Patil-Vinay/Robocon-2022/docs/wiring/r1_schematic.png

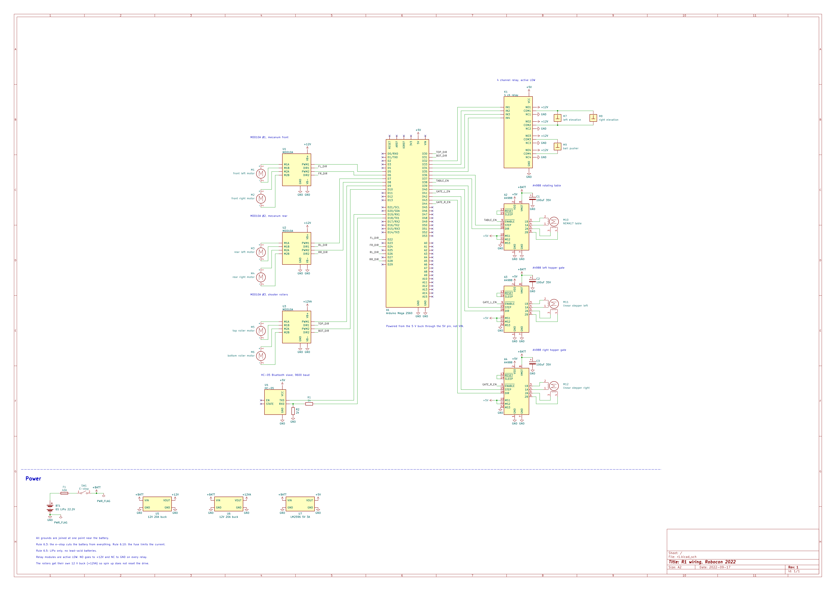
docs/wiring/r1_schematic.png
