Patil-Vinay/Robocon-2022/docs/wiring/r2_schematic.png

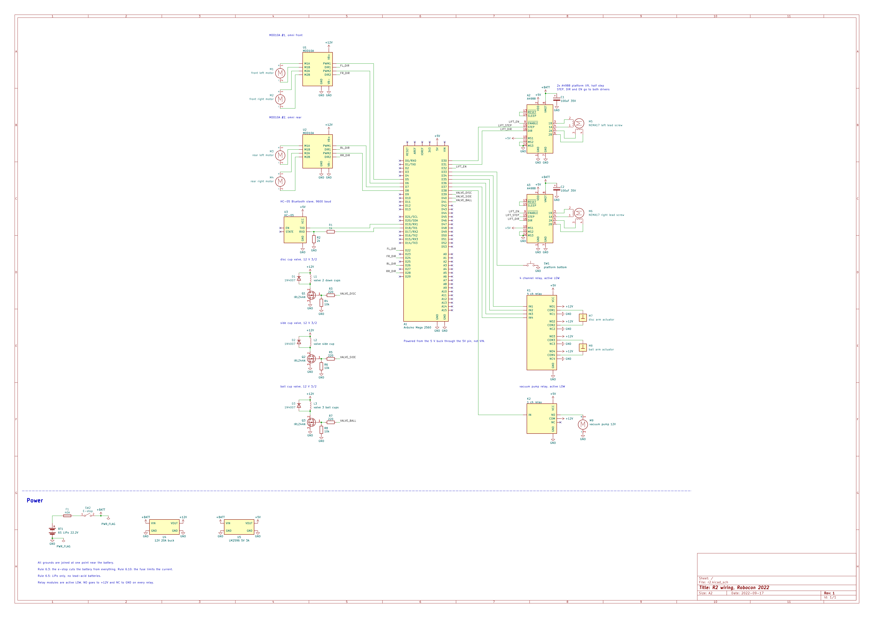
docs/wiring/r2_schematic.png
