Patil-Vinay/Robocon-2022/docs/wiring/remote_schematic.png

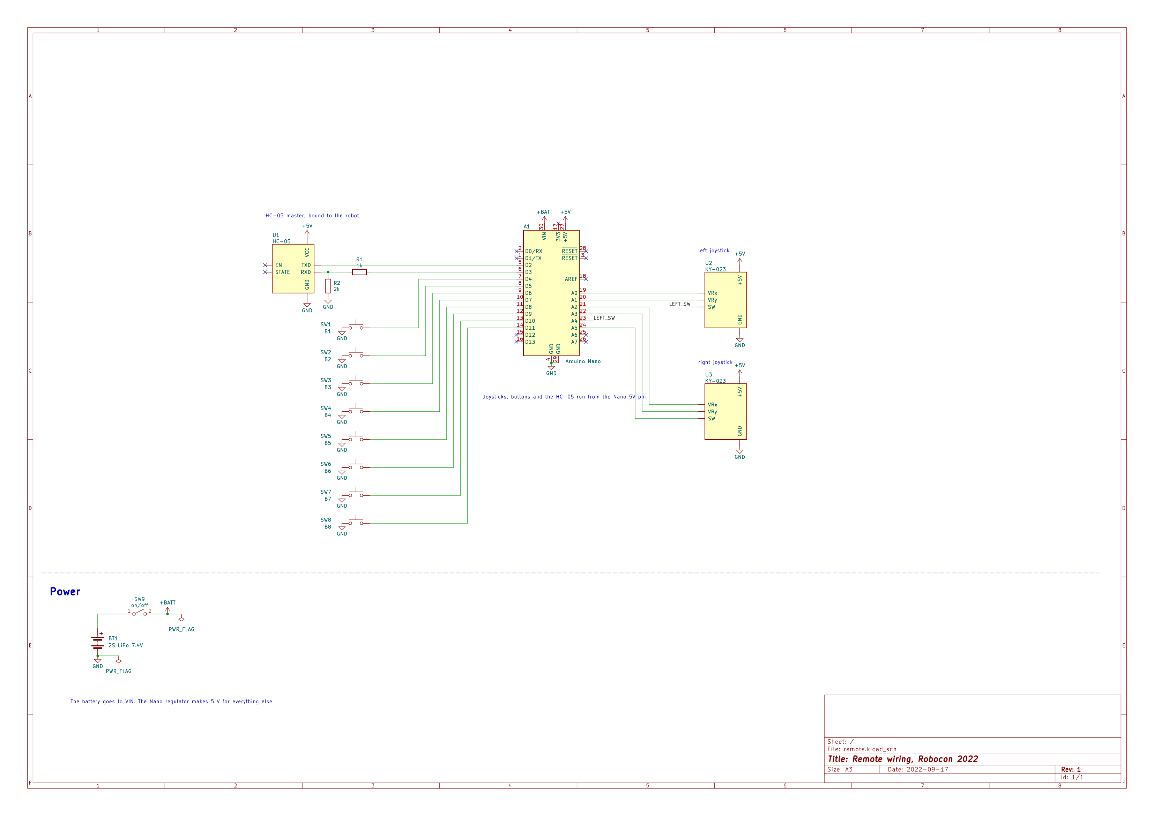
docs/wiring/remote_schematic.png
