Patil-Vinay/Robocon-2022/R1_Robot_Design.png

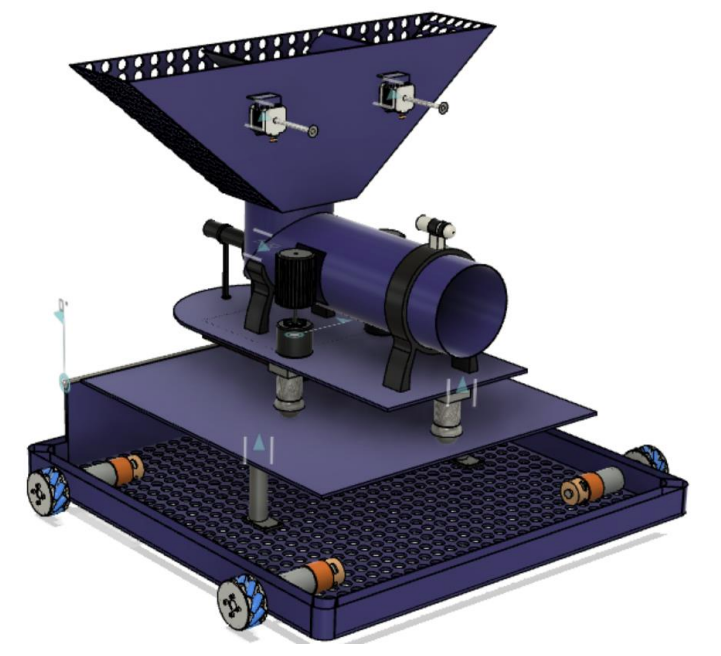
R1_Robot_Design.png
