Patil-Vinay/Robocon-2022/cad/r1/r1_body.step

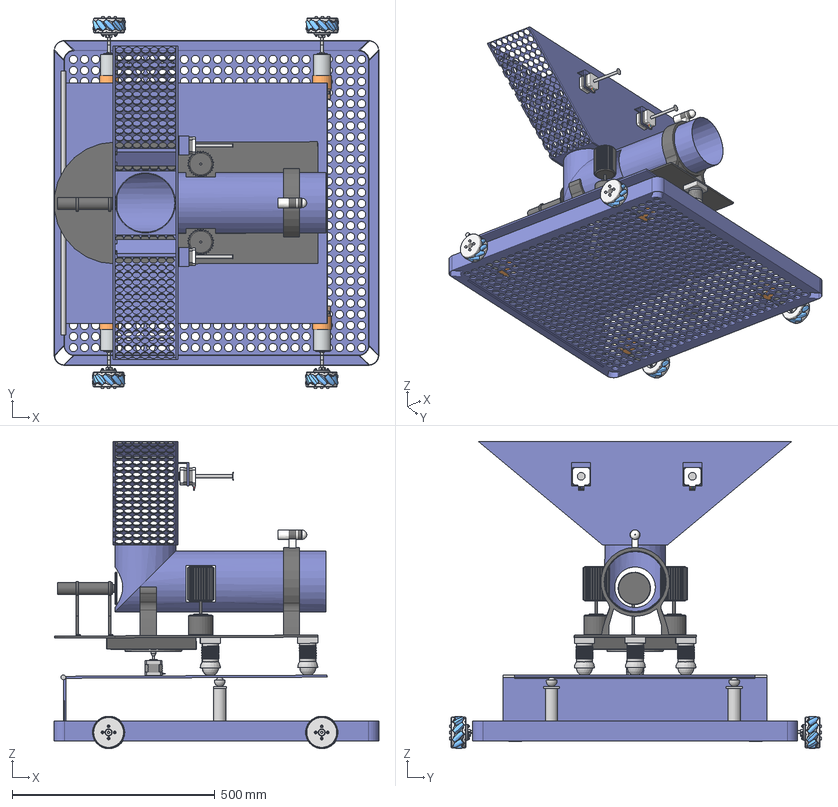
[picture p8: CAD file, 2022-07-25]
cad/r1/r1_body.step
800.0 x 916.4 x 756.4 mm
Caster Wheel x 3
R.Table Gear&Hydraulics
roatating table perforated
hinge
hinge part
M4 Screw 20mm x 2
M4 Screw 20mm (1) x 2
M4 Screw 20mm (2) x 2
M4 Screw 20mm (3) x 2
Cap x 2
Base x 2
Core Laminate x 2
Parts x 2
Parts1
DC Mega torque motor 12 V x 4
Wheel outer side Left x 4
Wheel base plate 1 Left x 4
Roller 3 x 40
Shaft Coupler Nema 17 x 4
hex nut style 1 gradeab_din_Hexagon Nut ISO 4032 - M4 - W - N x 16
Roller Shaft x 40
socket head cap screw_am_B18.3.1M - 4 x 0.7 x 45 Hex SHCS -- 20NHX x 16
