Patil-Vinay/Robocon-2022/cad/r2/parts/omni_wheel.step

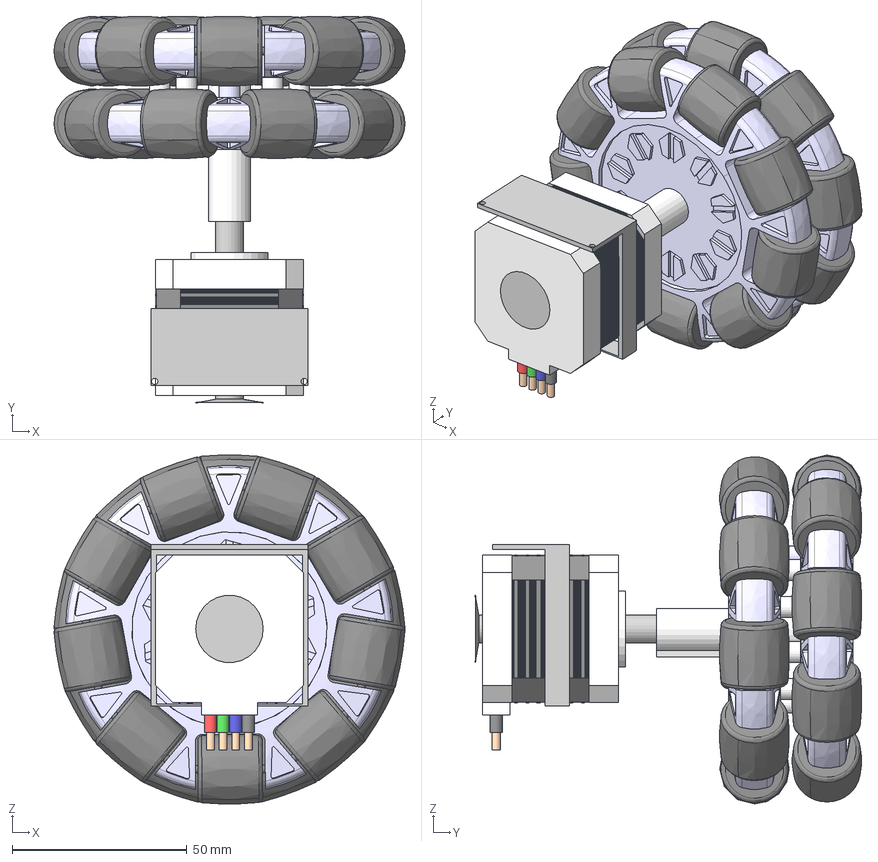
[picture p9: CAD file, 2022-07-25]
cad/r2/parts/omni_wheel.step
100.5 x 110.7 x 99.9 mm
Omnidirectional Wheel
Omnidirectional Wheel1
screw
bolt
