Patil-Vinay/Robocon-2022/cad/r2/r2_body.step

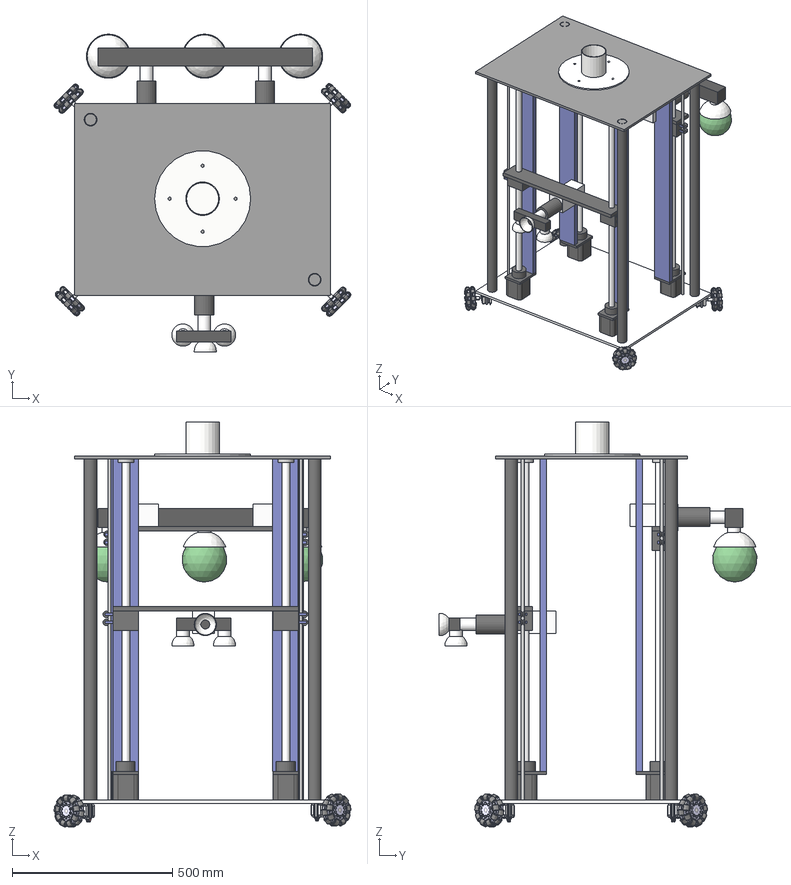
[picture p10: CAD file, 2022-07-25]
cad/r2/r2_body.step
926.9 x 992.5 x 1265.0 mm
lifting support (1) x 2
lifting support x 2
lifting shaft x 4
ball bearings x 4
lifting mechanism screw x 4
lifting mechanism x 4
shaft support x 4
suction cup support (2) x 2
linear actuator body x 3
linear actuator rod (1) x 3
linear actuator rod x 3
suction cup support
suction cup support (1) x 5
suction cups (1) x 3
wheels x 8
wheels (1) x 8
wheel body x 16
Omnidirectional Wheel x 4
Omnidirectional Wheel1 x 4
screw x 4
bolt x 4
suction cup support (3)
suction cups x 3
robot top plate
pLATE
