Patil-Vinay/Robocon-2022/r1 parts_/Rotating Table Mechanism v16.step

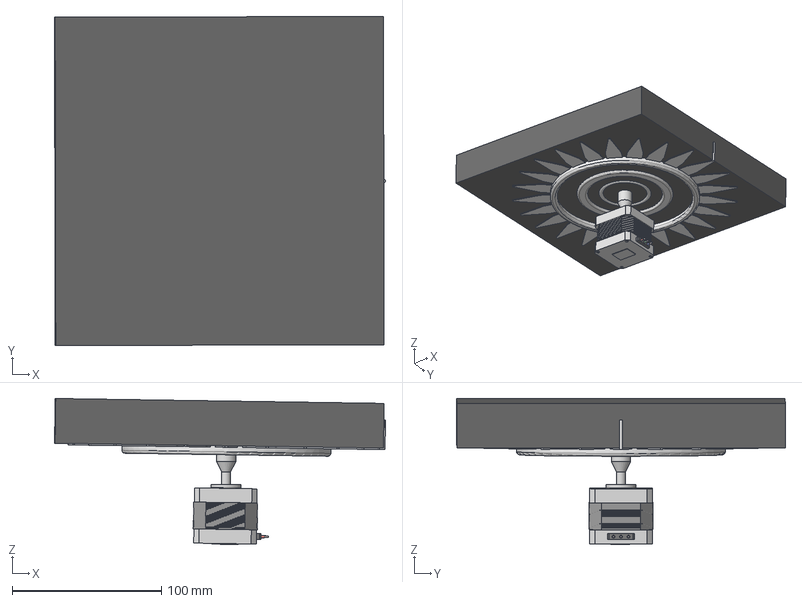
[picture p11: CAD file, 2022-07-17]
r1 parts_/Rotating Table Mechanism v16.step
221.7 x 220.4 x 97.8 mm
R.Table Gear&Hydraulics
