Patil-Vinay/Robocon-2022/r2 parts_/Head plate.step

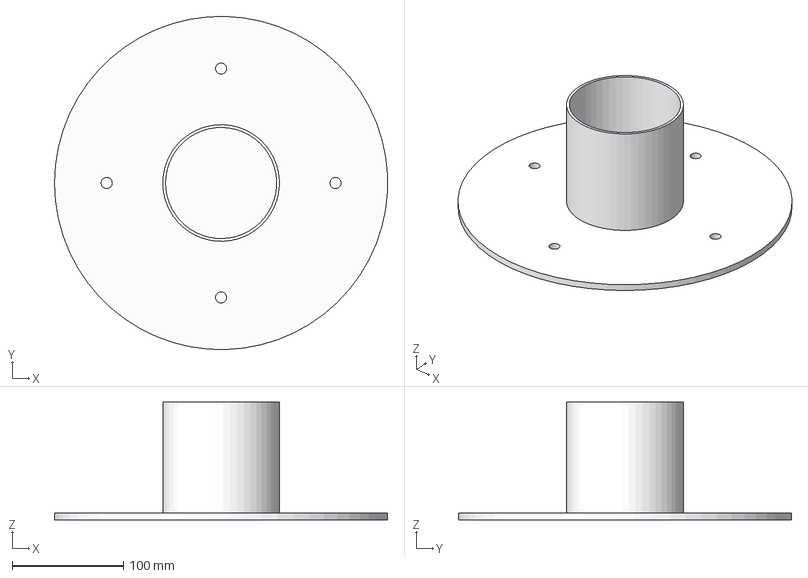
[picture p12: CAD file, 2022-07-17]
r2 parts_/Head plate.step
299.8 x 299.9 x 106.0 mm
