Patil-Vinay/Robocon-2022/cad/r1/parts/seeker_lagori_breaking.step

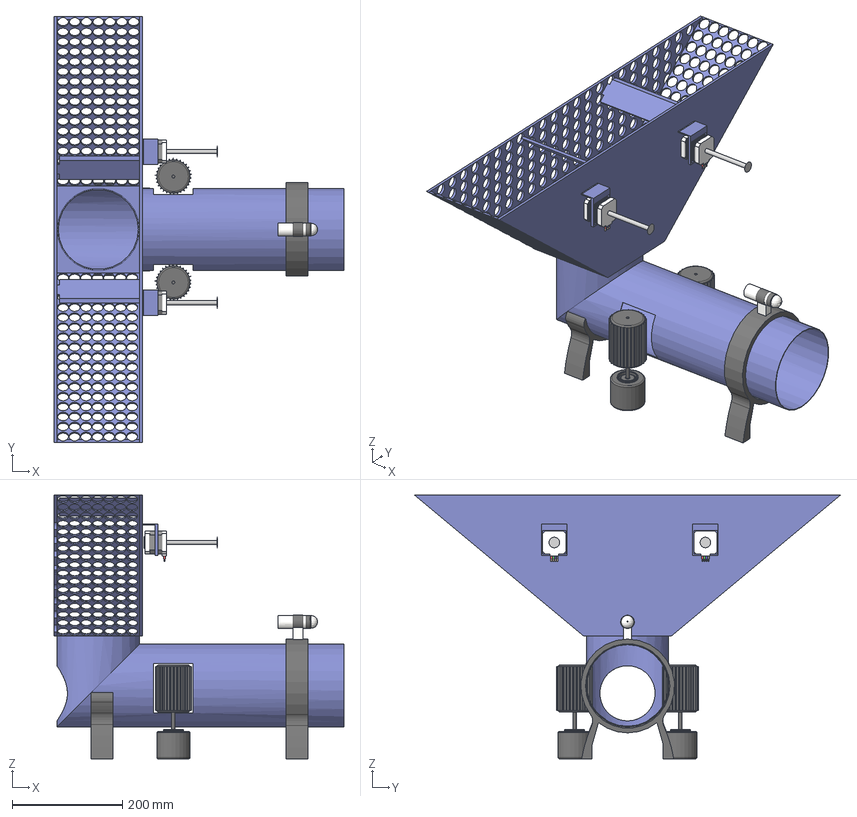
[picture p13: CAD file, 2022-07-25]
cad/r1/parts/seeker_lagori_breaking.step
525.0 x 772.0 x 478.0 mm
Parts x 2
Parts1
