Patil-Vinay/Robocon-2022/cad/r2/parts/hitter_ball_picking.step

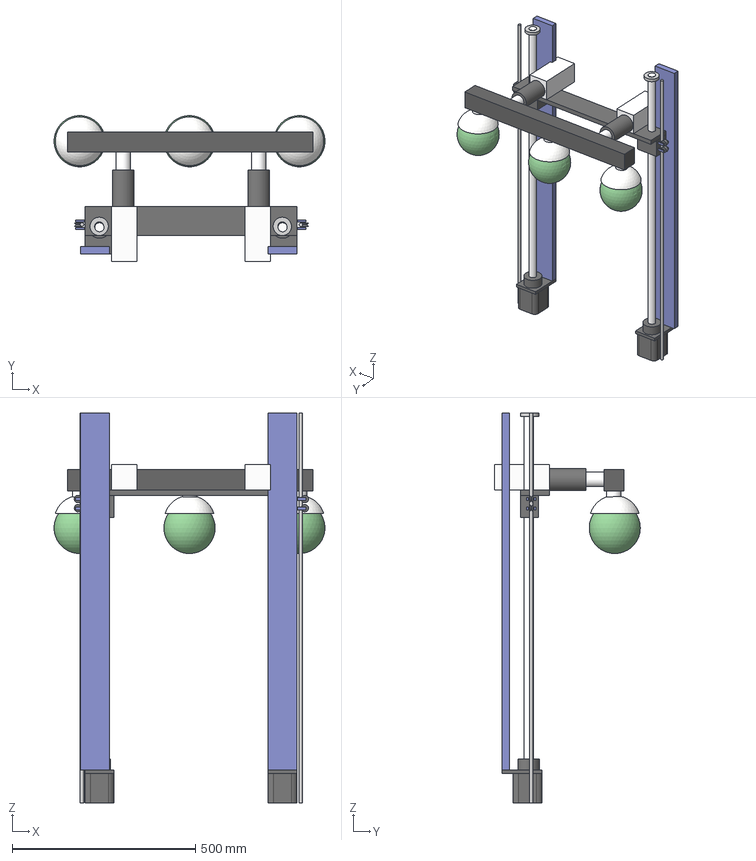
[picture p14: CAD file, 2022-07-17]
cad/r2/parts/hitter_ball_picking.step
739.7 x 397.7 x 1065.0 mm
lifting support (1)
lifting support
lifting shaft x 2
ball bearings x 2
lifting mechanism screw x 2
lifting mechanism x 2
shaft support x 2
suction cup support (2)
linear actuator body x 2
linear actuator rod (1) x 2
linear actuator rod x 2
suction cup support
suction cup support (1) x 3
suction cups (1) x 3
wheels x 4
wheels (1) x 4
wheel body x 8
