Patil-Vinay/Robocon-2022/r1 parts_/roatating table perforated v7.step

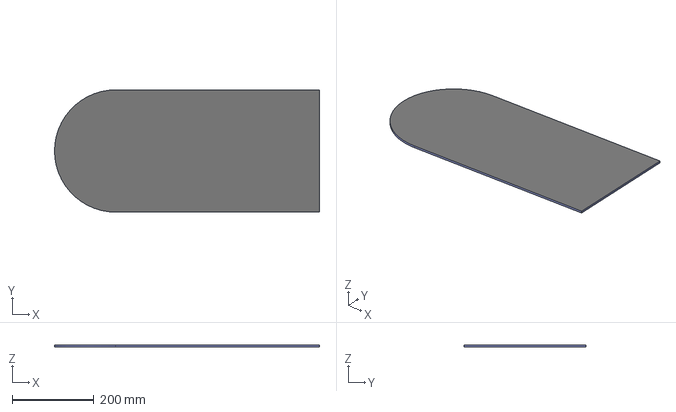
[picture p15: CAD file, 2022-07-17]
r1 parts_/roatating table perforated v7.step
650.0 x 300.0 x 5.00 mm
