Patil-Vinay/Robocon-2022/r2 parts_/Piling up the lagori discs(Seeker R2) .step

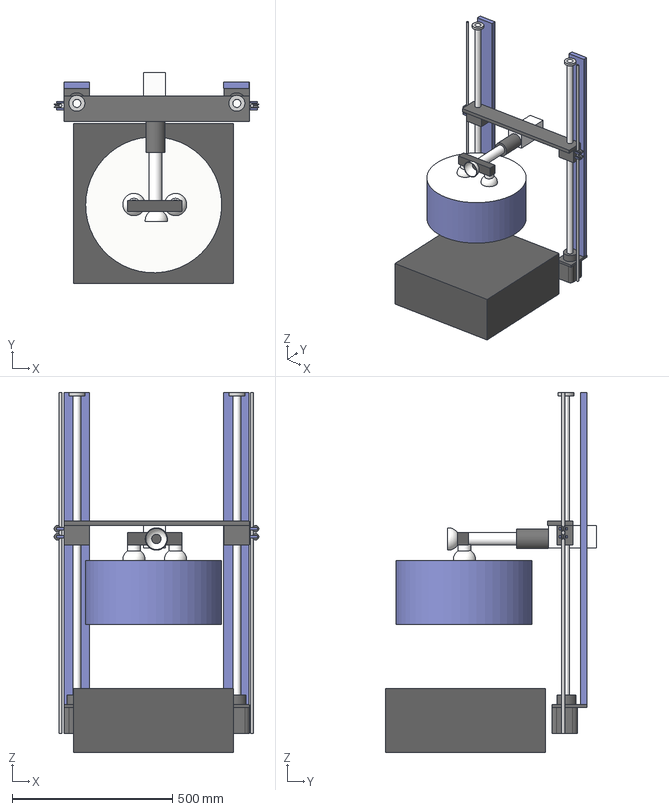
[picture p16: CAD file, 2022-07-17]
r2 parts_/Piling up the lagori discs(Seeker R2) .step
640.0 x 660.2 x 1125.0 mm
lifting support (1)
lifting support
wheel body x 8
wheels x 4
wheels (1) x 4
suction cup support (2)
shaft support x 2
lifting mechanism x 2
lifting mechanism screw x 2
ball bearings x 2
lifting shaft x 2
linear actuator body
linear actuator rod (1)
linear actuator rod
suction cup support (3)
suction cup support (1) x 2
suction cups x 3
Lagori (New)
