Patil-Vinay/Robocon-2022/cad/r1/parts/linear_actuator_piston.step

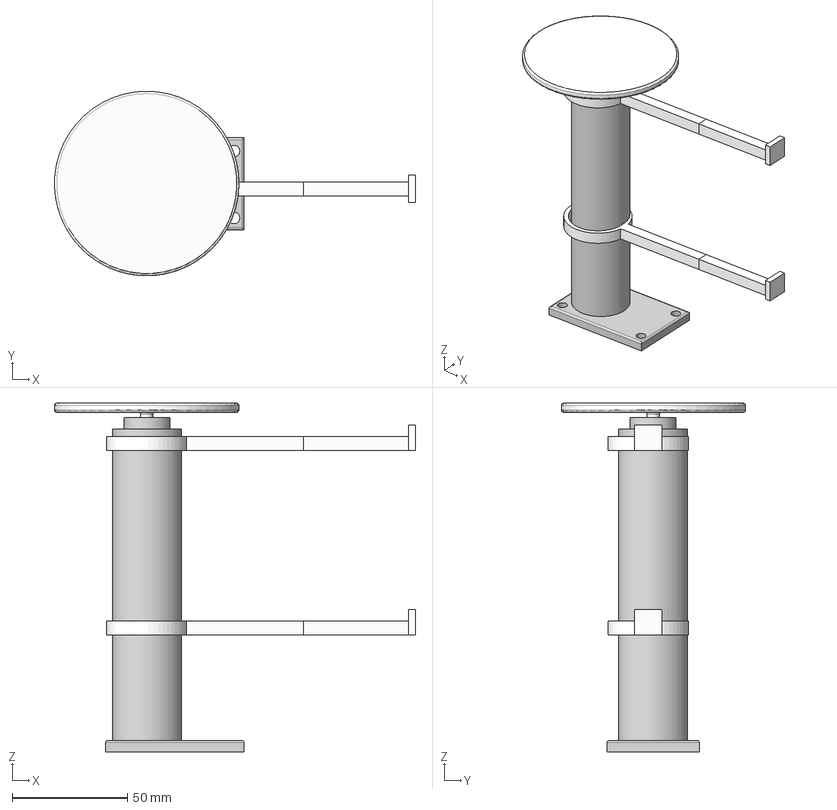
[picture p17: CAD file, 2022-07-17]
cad/r1/parts/linear_actuator_piston.step
156.5 x 80.0 x 151.1 mm
M4 Screw 20mm x 2
M4 Screw 20mm (1) x 2
M4 Screw 20mm (2) x 2
M4 Screw 20mm (3) x 2
Cap x 2
Base x 2
Core Laminate x 2
