Patil-Vinay/Robocon-2022/r1 parts_/Caster Wheel v13.step

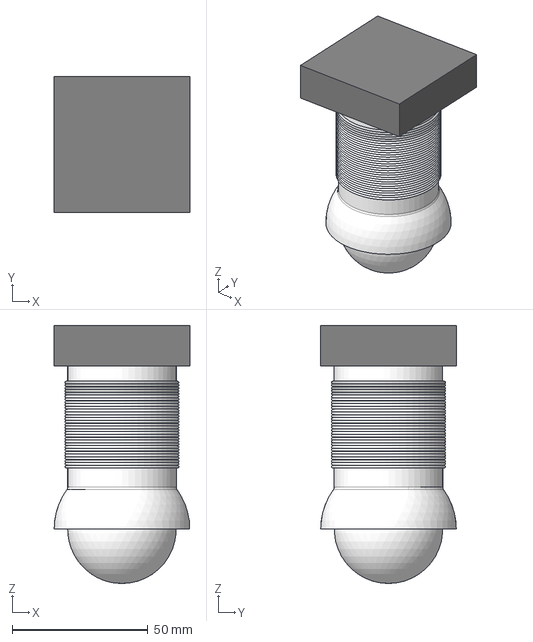
[picture p18: CAD file, 2022-07-17]
r1 parts_/Caster Wheel v13.step
50.0 x 50.0 x 95.0 mm
