Patil-Vinay/Robocon-2022/cad/r1/parts/mecanum_wheel.step

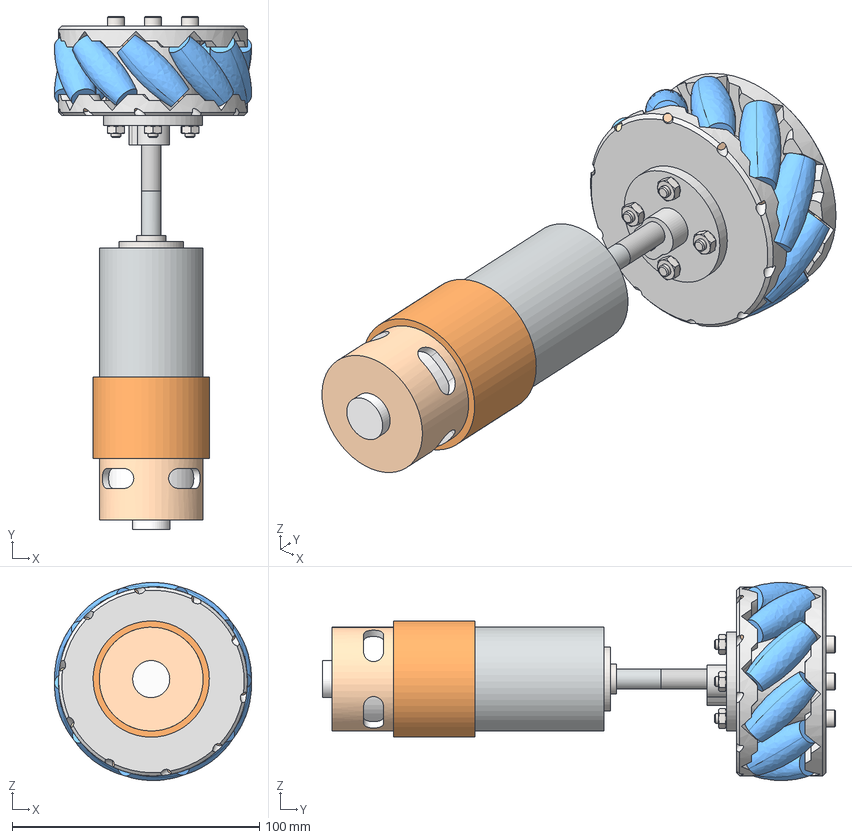
[picture p19: CAD file, 2022-07-17]
cad/r1/parts/mecanum_wheel.step
79.7 x 207.7 x 80.2 mm
DC Mega torque motor 12 V
Wheel outer side Left
Wheel base plate 1 Left
Roller 3 x 10
Shaft Coupler Nema 17
hex nut style 1 gradeab_din_Hexagon Nut ISO 4032 - M4 - W - N x 4
Roller Shaft x 10
socket head cap screw_am_B18.3.1M - 4 x 0.7 x 45 Hex SHCS -- 20NHX x 4
