Patil-Vinay/Robocon-2022/cad/r1/parts/hydraulics_perforated.step

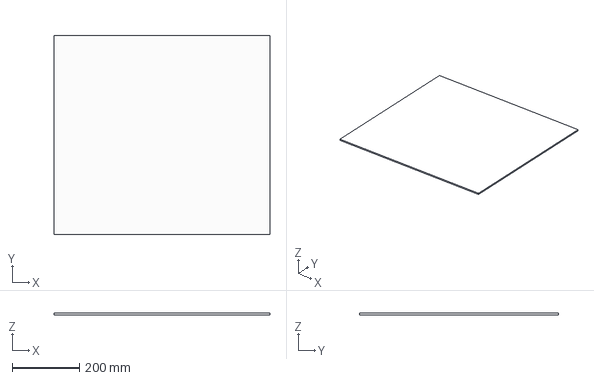
[picture p20: CAD file, 2022-07-17]
cad/r1/parts/hydraulics_perforated.step
644.0 x 592.0 x 5.00 mm
