Patil-Vinay/Robocon-2022/cad/r1/parts/linear_actuator.step

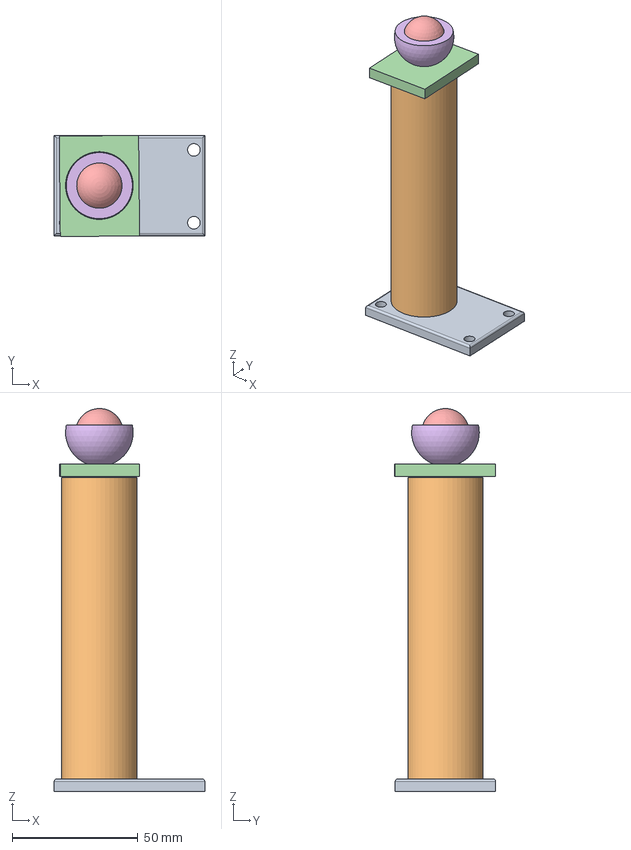
[picture p21: CAD file, 2022-07-17]
cad/r1/parts/linear_actuator.step
60.0 x 40.3 x 152.5 mm
