Patil-Vinay/Robocon-2022/(commit log)

2022-07-25 Move CAD files into cad/ and fix file names
    Typos in the file names (maual, acctuator, roatating, mecnum) are fixed and the version suffixes are dropped. R1 and R2 each get their own folder with the parts under parts/.
2022-09-17 Add wiring schematics for R1, R2 and the remote, update README
